ovdessel/NixieSpeaker/NixieRadio.kicad_pcb

## KiCad design NixieRadio.kicad_pcb (2022-07-15)

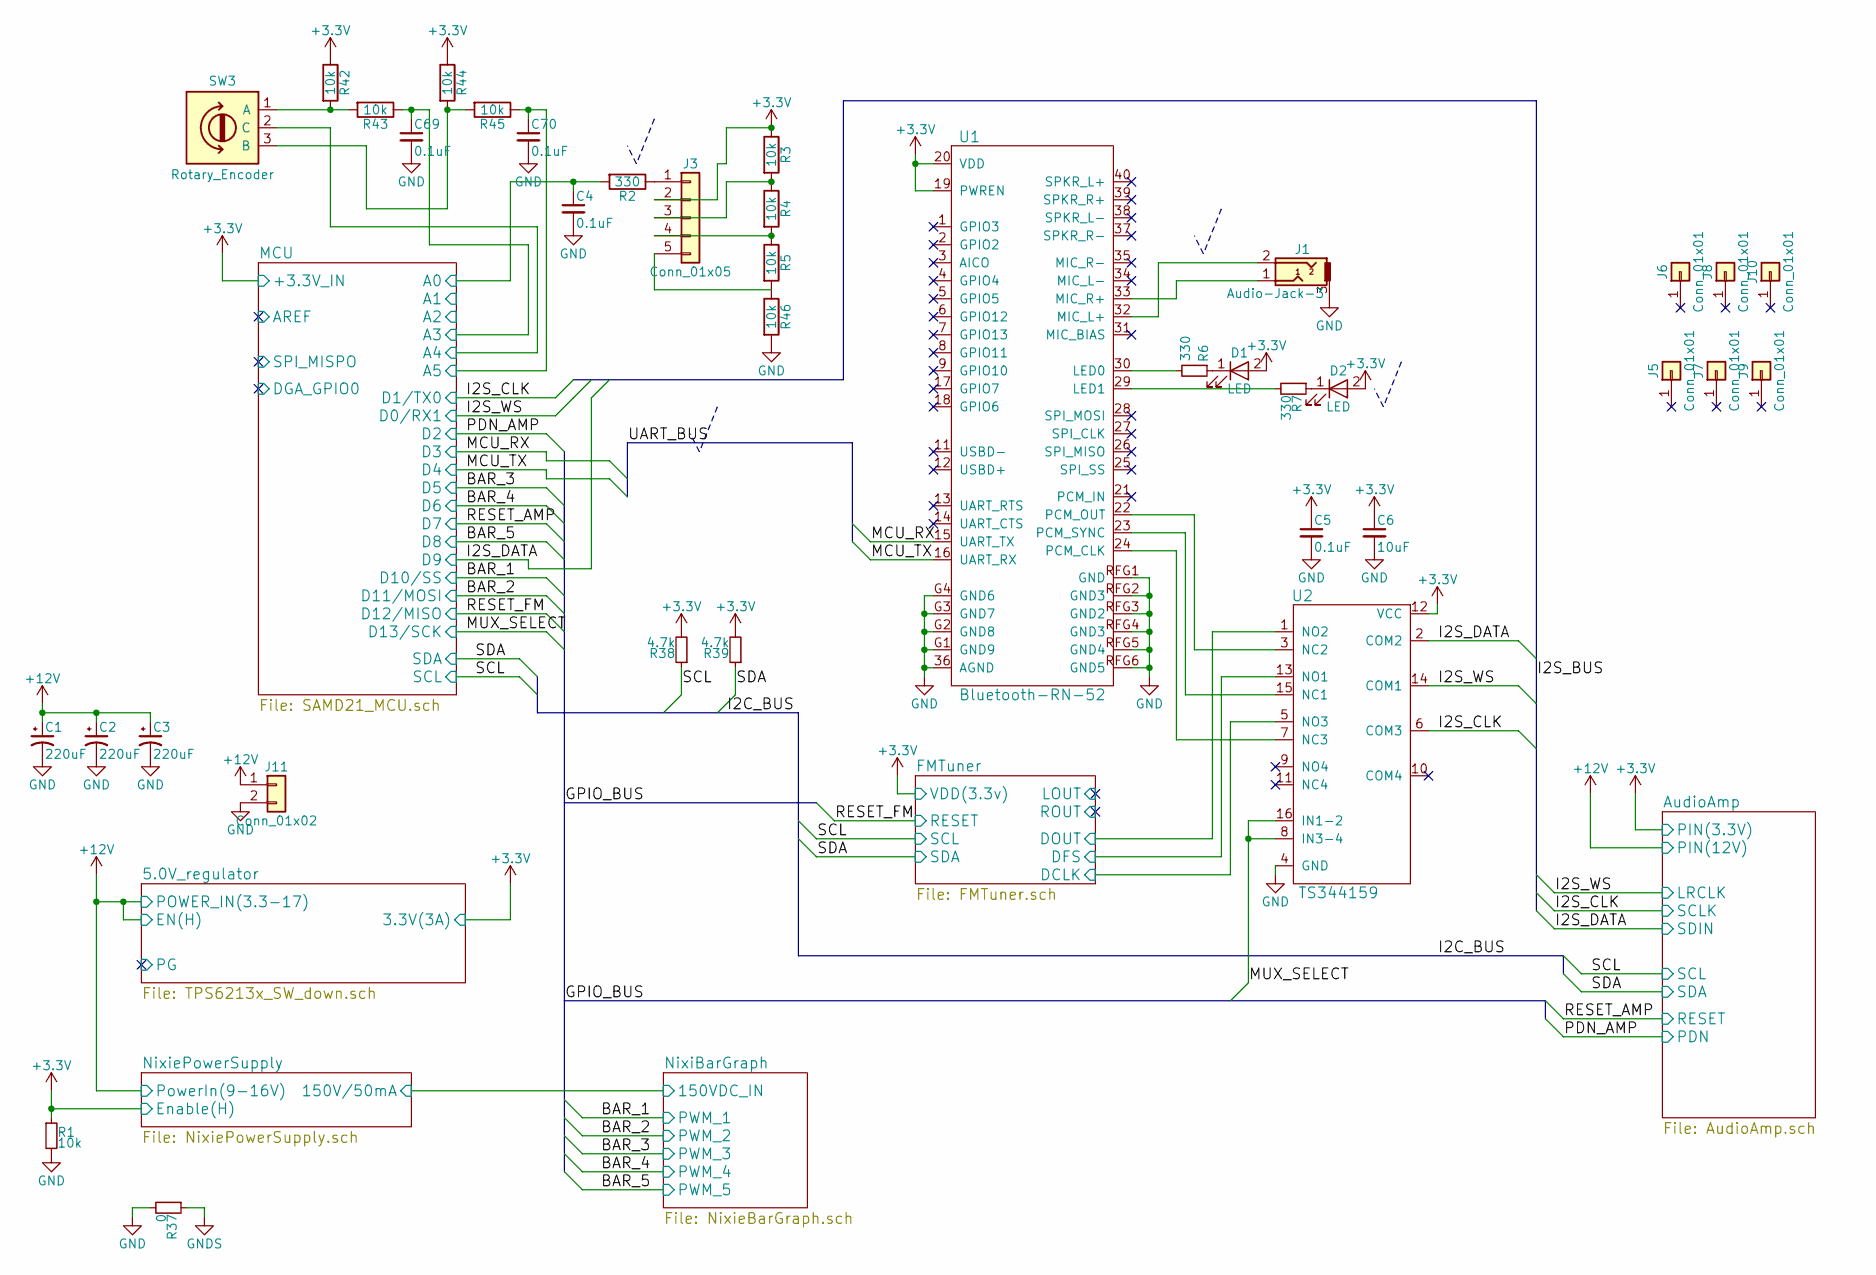
[picture p1: schematic NixieRadio.sch]

Parts:
C1, C2, C3: 220uF; CP_Elec_8x10
C4, C5, C69, C70: 0.1uF; 0603-CAP
C6: 10uF; 0603-CAP
D1, D2: LED; LED_0603
J1: Audio-Jack-3; 1X03
J3: Conn_01x05; 1X05
J5, J6, J7, J8, J9, J10: Conn_01x01; STAND-OFF
J11: Conn_01x02; 1X02_BIG
R1, R3, R4, R5, R42, R43, R44, R45, R46: 10k; 0603-RES
R2, R6, R7: 330; 0603-RES
R37: 0; R_1210_HandSoldering
R38, R39: 4.7k; 0603-RES
SW3: Rotary_Encoder; 1X03
U1: Bluetooth-RN-52; RN-52
U2: TS344159; TSSOP16

Connections:
+3V3: C5.1, C6.1, D1.2 (A), D2.2 (A), J3.2, R1.1, R3.1, R38.2, R39.2, R42.1, R44.1, U1.19 (PWREN), U1.20 (VDD), U2.12 (VCC); also elsewhere on the board
+12V: C1.1, C2.1, C3.1, J11.1; also elsewhere on the board
/FMTuner/DCLK: U2.5 (NO3); also elsewhere on the board
/FMTuner/DFS: U2.13 (NO1); also elsewhere on the board
/FMTuner/DOUT: U2.1 (NO2); also elsewhere on the board
/I2S_CLK: U2.6 (COM3); also elsewhere on the board
/I2S_DATA: U2.2 (COM2); also elsewhere on the board
/I2S_WS: U2.14 (COM1); also elsewhere on the board
/MCU/A0: C4.1, R2.2; also elsewhere on the board
/MCU/A3: C69.1, R43.1; also elsewhere on the board
/MCU/A4: SW3.2 (C); also elsewhere on the board
/MCU/A5: C70.1, R45.1; also elsewhere on the board
/MCU_RX: U1.15 (UART_TX); also elsewhere on the board
/MCU_TX: U1.16 (UART_RX); also elsewhere on the board
/MUX_SELECT: U2.8 (IN3-4), U2.16 (IN1-2); also elsewhere on the board
/SCL: R38.1; also elsewhere on the board
/SDA: R39.1; also elsewhere on the board
GND: C1.2, C2.2, C3.2, C4.2, C5.2, C6.2, C69.2, C70.2, J1.3, J11.2, R1.2, R37.2, R46.2, U1.36 (AGND), U1.G1 (GND9), U1.G2 (GND8), U1.G3 (GND7), U1.G4 (GND6), U1.RFG1 (GND), U1.RFG2 (GND3), U1.RFG3 (GND2), U1.RFG4 (GND3), U1.RFG5 (GND4), U1.RFG6 (GND5), U2.4 (GND); also elsewhere on the board
GNDS: R37.1; also elsewhere on the board
unnamed: D1.1 (K), R6.1
unnamed: D2.1 (K), R7.1
unnamed: J1.1, U1.33 (MIC_R+)
unnamed: J1.2, U1.32 (MIC_L+)
unnamed: J3.1, R2.1
unnamed: J3.3, R3.2, R4.1
unnamed: J3.4, R4.2, R5.1
unnamed: J3.5, R5.2, R46.1
unnamed: R6.2, U1.30 (LED0)
unnamed: R7.2, U1.29 (LED1)
unnamed: R42.2, R43.2, SW3.1 (A)
unnamed: R44.2, R45.2, SW3.3 (B)
unnamed: U1.22 (PCM_OUT), U2.3 (NC2)
unnamed: U1.23 (PCM_SYNC), U2.15 (NC1)
unnamed: U1.24 (PCM_CLK), U2.7 (NC3)

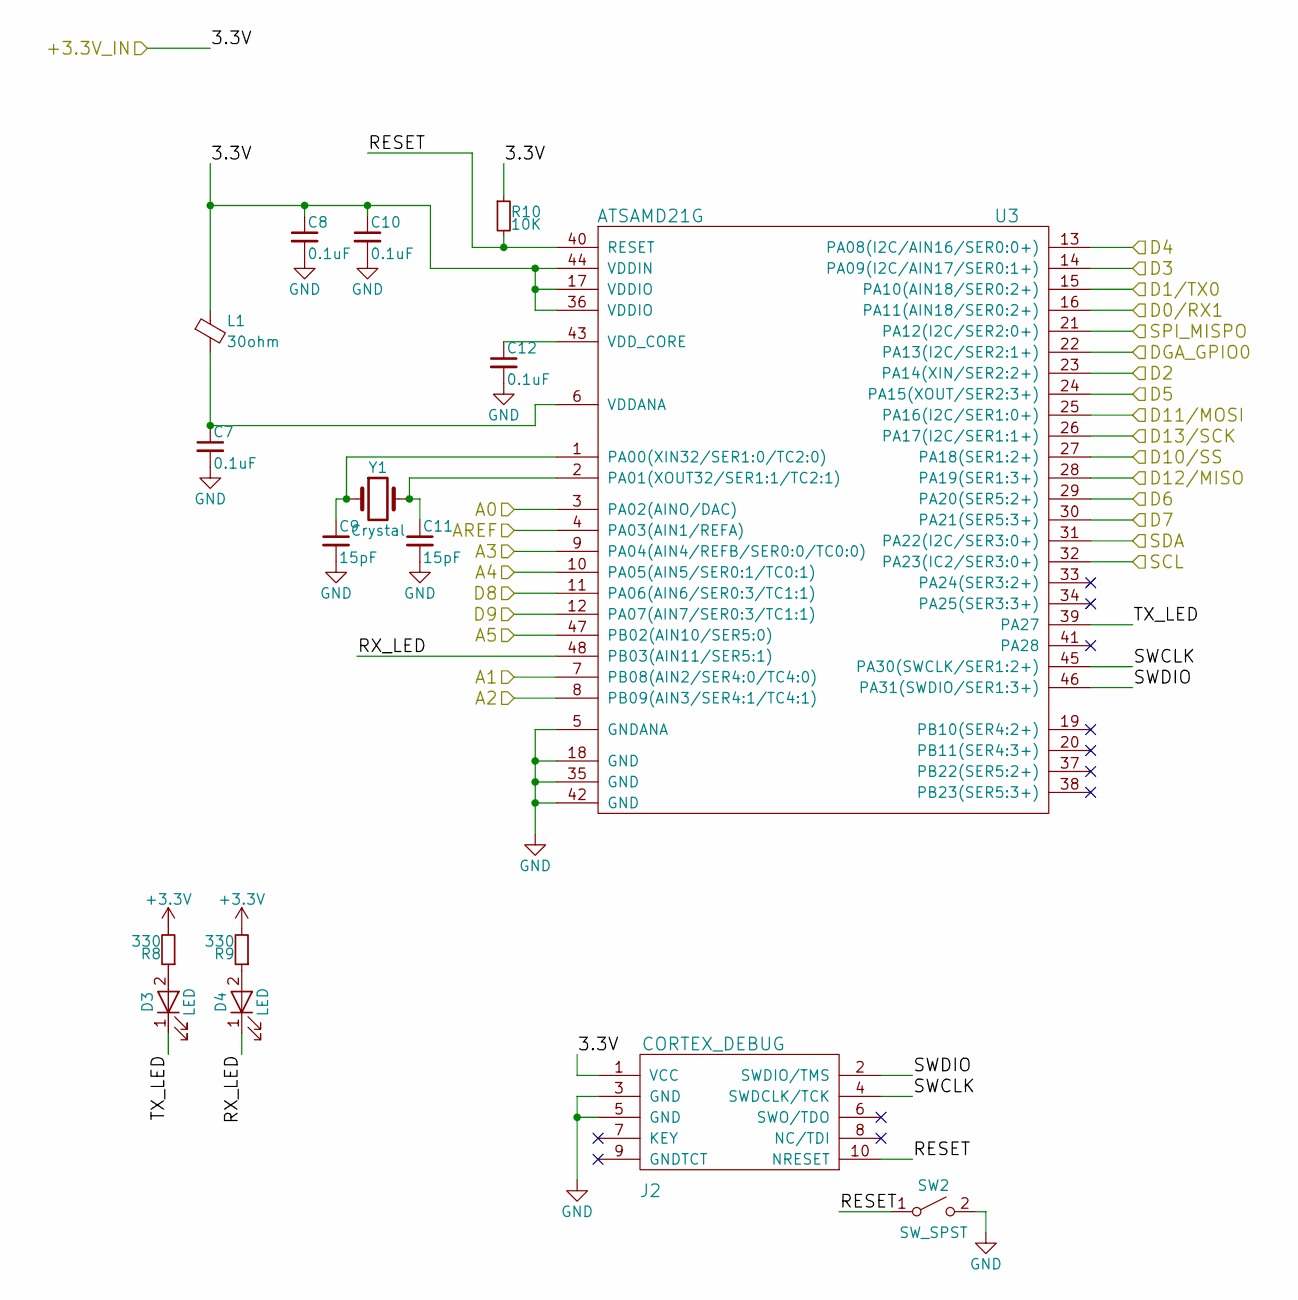
[picture p2: schematic SAMD21_MCU.sch]

Parts:
C7, C8, C10, C12: 0.1uF; 0603-CAP
C9, C11: 15pF; 0603-CAP
D3, D4: LED; LED_0603
J2: CORTEX_DEBUG; 2X5-PTH-1.27MM
L1: 30ohm; R_0603
R8, R9: 330; 0603-RES
R10: 10K; 0603-RES
SW2: SW_SPST; SW_SPST_B3U-1000P
U3: ATSAMD21G; TQFP-48
Y1: Crystal; Crystal_AT310_d3.0mm_l10.0mm_Horizontal

Connections:
+3V3: C8.1, C10.1, J2.1 (VCC), L1.1, R8.2, R9.2, R10.1, U3.17 (VDDIO), U3.36 (VDDIO), U3.44 (VDDIN); also elsewhere on the board
/BAR_1: U3.27 (PA18(SER1:2+)); also elsewhere on the board
/BAR_2: U3.25 (PA16(I2C/SER1:0+)); also elsewhere on the board
/BAR_3: U3.24 (PA15(XOUT/SER2:3+)); also elsewhere on the board
/BAR_4: U3.29 (PA20(SER5:2+)); also elsewhere on the board
/BAR_5: U3.11 (PA06(AIN6/SER0:3/TC1:1)); also elsewhere on the board
/I2S_CLK: U3.15 (PA10(AIN18/SER0:2+)); also elsewhere on the board
/I2S_DATA: U3.12 (PA07(AIN7/SER0:3/TC1:1)); also elsewhere on the board
/I2S_WS: U3.16 (PA11(AIN18/SER0:2+)); also elsewhere on the board
/MCU/A0: U3.3 (PA02(AINO/DAC)); also elsewhere on the board
/MCU/A1: U3.7 (PB08(AIN2/SER4:0/TC4:0))
/MCU/A2: U3.8 (PB09(AIN3/SER4:1/TC4:1))
/MCU/A3: U3.9 (PA04(AIN4/REFB/SER0:0/TC0:0)); also elsewhere on the board
/MCU/A4: U3.10 (PA05(AIN5/SER0:1/TC0:1)); also elsewhere on the board
/MCU/A5: U3.47 (PB02(AIN10/SER5:0)); also elsewhere on the board
/MCU/AREF: U3.4 (PA03(AIN1/REFA))
/MCU/DGA_GPIO0: U3.22 (PA13(I2C/SER2:1+))
/MCU/RESET: J2.10 (NRESET), R10.2, SW2.1 (A), U3.40 (RESET)
/MCU/RX_LED: D4.1 (K), U3.48 (PB03(AIN11/SER5:1))
/MCU/SPI_MISPO: U3.21 (PA12(I2C/SER2:0+))
/MCU/SWCLK: J2.4 (SWDCLK/TCK), U3.45 (PA30(SWCLK/SER1:2+))
/MCU/SWDIO: J2.2 (SWDIO/TMS), U3.46 (PA31(SWDIO/SER1:3+))
/MCU/TX_LED: D3.1 (K), U3.39 (PA27)
/MCU_RX: U3.14 (PA09(I2C/AIN17/SER0:1+)); also elsewhere on the board
/MCU_TX: U3.13 (PA08(I2C/AIN16/SER0:0+)); also elsewhere on the board
/MUX_SELECT: U3.26 (PA17(I2C/SER1:1+)); also elsewhere on the board
/PDN_AMP: U3.23 (PA14(XIN/SER2:2+)); also elsewhere on the board
/RESET_AMP: U3.30 (PA21(SER5:3+)); also elsewhere on the board
/RESET_FM: U3.28 (PA19(SER1:3+)); also elsewhere on the board
/SCL: U3.32 (PA23(IC2/SER3:0+)); also elsewhere on the board
/SDA: U3.31 (PA22(I2C/SER3:0+)); also elsewhere on the board
GND: C7.2, C8.2, C9.2, C10.2, C11.2, C12.2, J2.3 (GND), J2.5 (GND), SW2.2 (B), U3.5 (GNDANA), U3.18 (GND), U3.35 (GND), U3.42 (GND); also elsewhere on the board
unnamed: C7.1, L1.2, U3.6 (VDDANA)
unnamed: C9.1, U3.1 (PA00(XIN32/SER1:0/TC2:0)), Y1.1
unnamed: C11.1, U3.2 (PA01(XOUT32/SER1:1/TC2:1)), Y1.2
unnamed: C12.1, U3.43 (VDD_CORE)
unnamed: D3.2 (A), R8.1
unnamed: D4.2 (A), R9.1

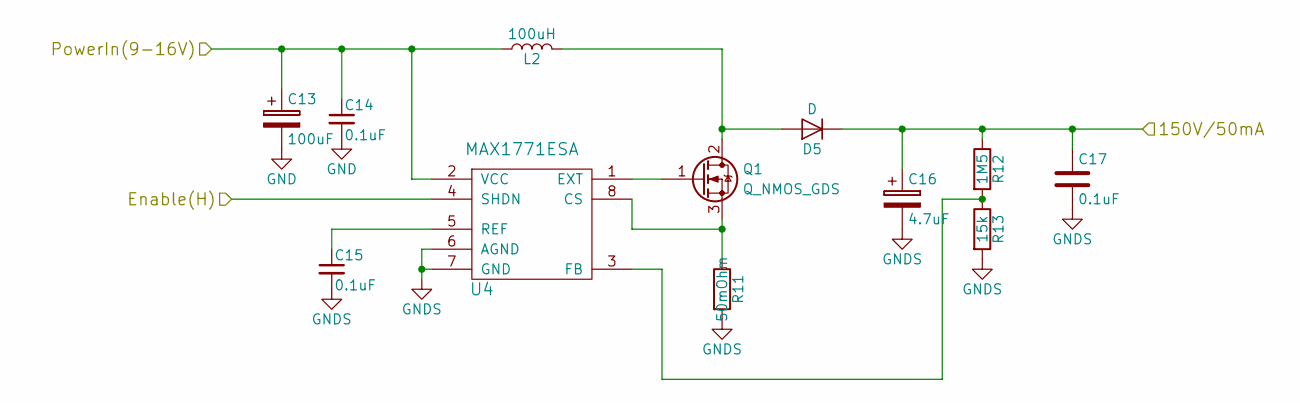
[picture p3: schematic NixiePowerSupply.sch]

Parts:
C13: 100uF; CP_Elec_8x10
C14, C15: 0.1uF; 0603-CAP
C16: 4.7uF; CP_Elec_10x10
C17: 0.1uF; C_2225_HandSoldering
D5: D; D_SMB
L2: 100uH; Inductor_Taiyo-Yuden_NR-80xx_HandSoldering
Q1: Q_NMOS_GDS; TO-220-3_Horizontal_Reversed
R11: 50mOhm; R_1210_HandSoldering
R12: 1M5; R_1210_HandSoldering
R13: 15k; 0603-RES
U4: MAX1771ESA; SO08

Connections:
+3V3: U4.4 (SHDN); also elsewhere on the board
+12V: C13.1, C14.1, L2.1, U4.2 (VCC); also elsewhere on the board
/NixiePowerSupply/150V/50mA: C16.1, C17.1, D5.1 (K), R12.1; also elsewhere on the board
GND: C13.2, C14.2; also elsewhere on the board
GNDS: C15.2, C16.2, C17.2, R11.2, R13.2, U4.6 (AGND), U4.7 (GND); also elsewhere on the board
unnamed: C15.1, U4.5 (REF)
unnamed: D5.2 (A), L2.2, Q1.2 (D)
unnamed: Q1.1 (G), U4.1 (EXT)
unnamed: Q1.3 (S), R11.1, U4.8 (CS)
unnamed: R12.2, R13.1, U4.3 (FB)

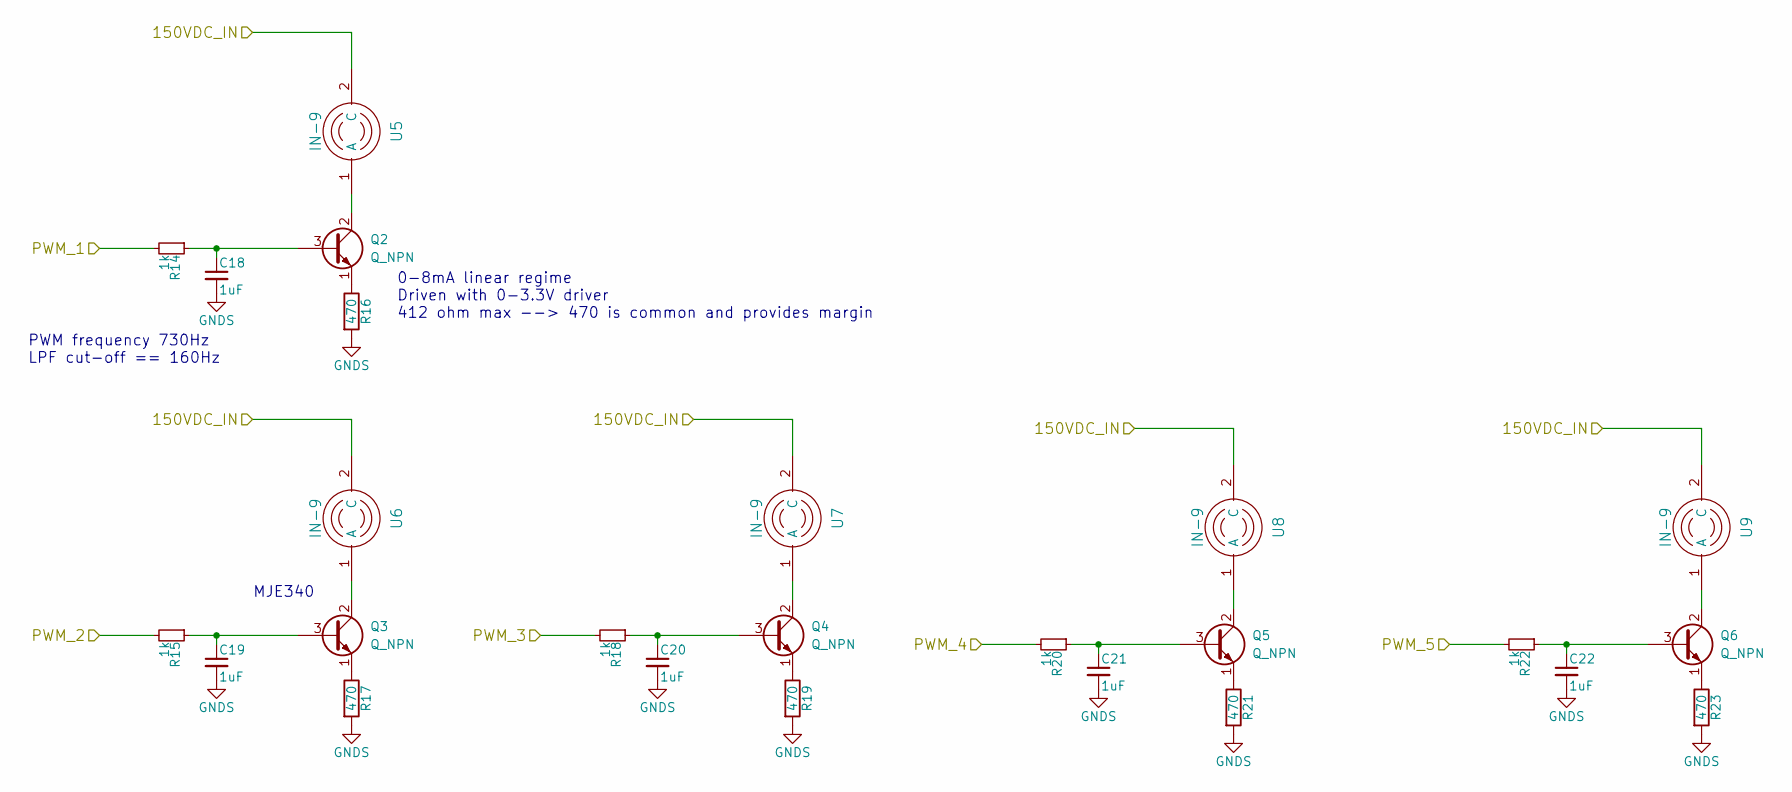
[picture p4: schematic NixieBarGraph.sch]

Parts:
C18, C19, C20, C21, C22: 1uF; 0603-CAP
Q2, Q3, Q4, Q5, Q6: Q_NPN; TO-92
R14, R15, R18, R20, R22: 1k; 0603-RES
R16, R17, R19, R21, R23: 470; 0603-RES
U5, U6, U7, U8, U9: IN-9; 1X02

Connections:
/BAR_1: R14.2; also elsewhere on the board
/BAR_2: R15.2; also elsewhere on the board
/BAR_3: R18.2; also elsewhere on the board
/BAR_4: R20.2; also elsewhere on the board
/BAR_5: R22.2; also elsewhere on the board
/NixiePowerSupply/150V/50mA: U5.2 (C), U6.2 (C), U7.2 (C), U8.2 (C), U9.2 (C); also elsewhere on the board
GNDS: C18.2, C19.2, C20.2, C21.2, C22.2, R16.2, R17.2, R19.2, R21.2, R23.2; also elsewhere on the board
unnamed: C18.1, Q2.3 (B), R14.1
unnamed: C19.1, Q3.3 (B), R15.1
unnamed: C20.1, Q4.3 (B), R18.1
unnamed: C21.1, Q5.3 (B), R20.1
unnamed: C22.1, Q6.3 (B), R22.1
unnamed: Q2.1 (E), R16.1
unnamed: Q2.2 (C), U5.1 (A)
unnamed: Q3.1 (E), R17.1
unnamed: Q3.2 (C), U6.1 (A)
unnamed: Q4.1 (E), R19.1
unnamed: Q4.2 (C), U7.1 (A)
unnamed: Q5.1 (E), R21.1
unnamed: Q5.2 (C), U8.1 (A)
unnamed: Q6.1 (E), R23.1
unnamed: Q6.2 (C), U9.1 (A)

Notes on the sheet:
0-8mA linear regime Driven with 0-3.3V driver 412 ohm max --> 470 is common and provides margin
PWM frequency 730Hz LPF cut-off == 160Hz
MJE340

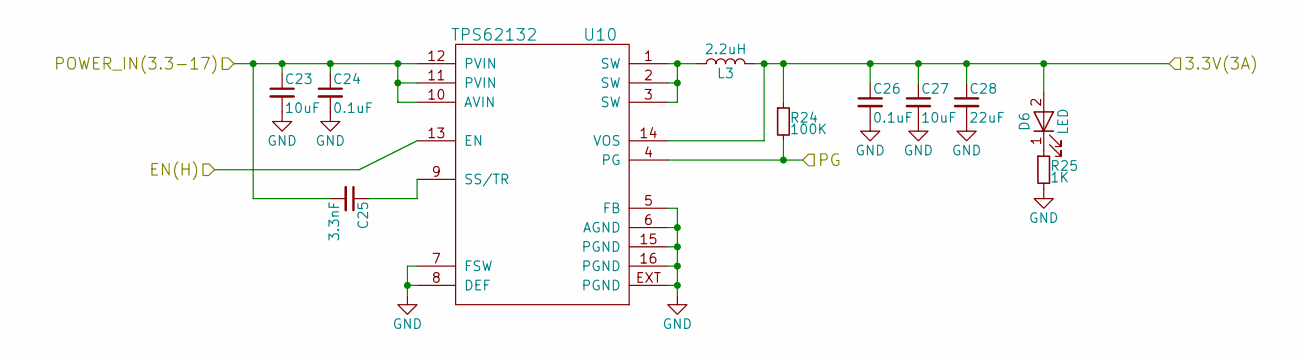
[picture p5: schematic TPS6213x_SW_down.sch]

Parts:
C23, C27: 10uF; 0603-CAP
C24, C26: 0.1uF; 0603-CAP
C25: 3.3nF; 0603-CAP
C28: 22uF; 0603-CAP
D6: LED; LED_0603
L3: 2.2uH; Inductor_1212
R24: 100K; 0603-RES
R25: 1K; 0603-RES
U10: TPS62132; QFN16-3X3MM_1%3a1_V03

Connections:
+3V3: C26.1, C27.1, C28.1, D6.2 (A), L3.2, R24.1, U10.14 (VOS); also elsewhere on the board
+12V: C23.1, C24.1, C25.2, U10.10 (AVIN), U10.11 (PVIN), U10.12 (PVIN), U10.13 (EN); also elsewhere on the board
/5.0V_regulator/PG: R24.2, U10.4 (PG)
GND: C23.2, C24.2, C26.2, C27.2, C28.2, R25.2, U10.5 (FB), U10.6 (AGND), U10.7 (FSW), U10.8 (DEF), U10.15 (PGND), U10.16 (PGND), U10.EXT (PGND); also elsewhere on the board
unnamed: C25.1, U10.9 (SS/TR)
unnamed: D6.1 (K), R25.1
unnamed: L3.1, U10.1 (SW), U10.2 (SW), U10.3 (SW)

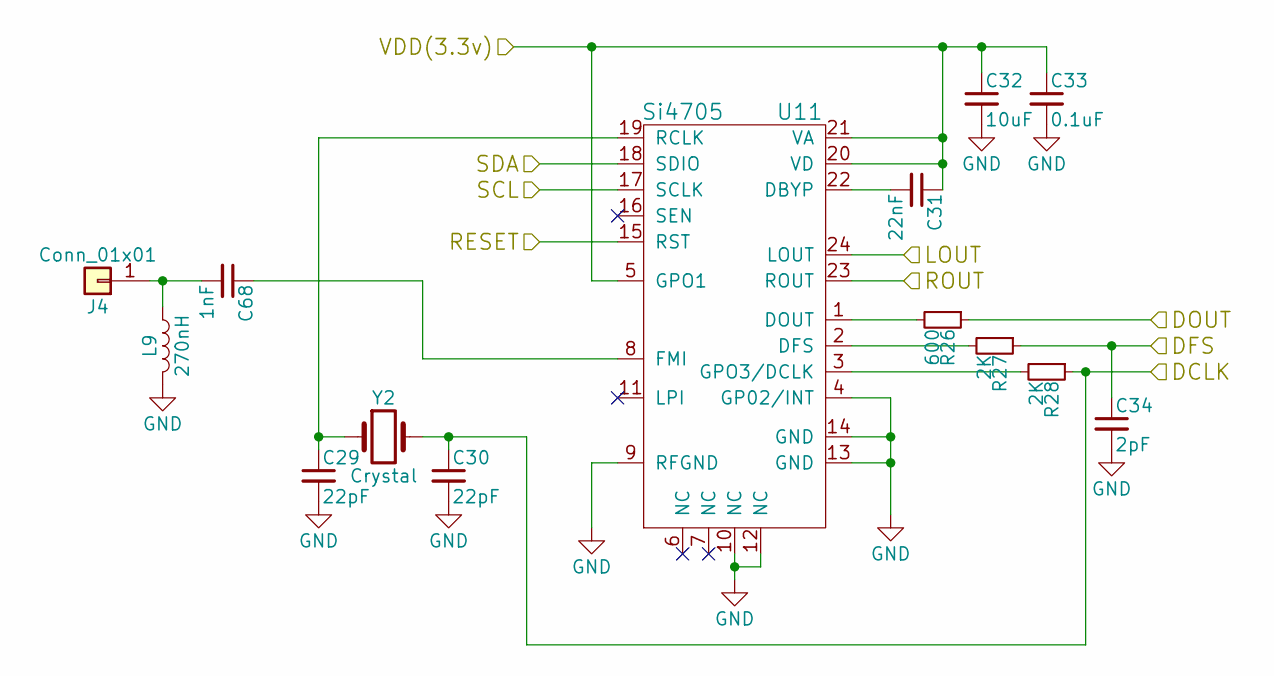
[picture p6: schematic FMTuner.sch]

Parts:
C29, C30: 22pF; 0603-CAP
C31: 22nF; 0603-CAP
C32: 10uF; 0603-CAP
C33: 0.1uF; 0603-CAP
C34: 2pF; 0603-CAP
C68: 1nF; 0603-CAP
J4: Conn_01x01; 1X01
L9: 270nH; Inductor_1212
R26: 600; 0603-RES
R27, R28: 2K; 0603-RES
U11: Si4705; SSOP24
Y2: Crystal; Crystal_AT310_d3.0mm_l10.0mm_Horizontal

Connections:
+3V3: C31.1, C32.1, C33.1, U11.5 (GPO1), U11.20 (VD), U11.21 (VA); also elsewhere on the board
/FMTuner/DCLK: C30.1, R28.1, Y2.2; also elsewhere on the board
/FMTuner/DFS: C34.1, R27.1; also elsewhere on the board
/FMTuner/DOUT: R26.1; also elsewhere on the board
/FMTuner/LOUT: U11.24 (LOUT)
/FMTuner/ROUT: U11.23 (ROUT)
/RESET_FM: U11.15 (RST); also elsewhere on the board
/SCL: U11.17 (SCLK); also elsewhere on the board
/SDA: U11.18 (SDIO); also elsewhere on the board
GND: C29.2, C30.2, C32.2, C33.2, C34.2, L9.2, U11.4 (GP02/INT), U11.9 (RFGND), U11.10 (NC), U11.12 (NC), U11.13 (GND), U11.14 (GND); also elsewhere on the board
unnamed: C29.1, U11.19 (RCLK), Y2.1
unnamed: C31.2, U11.22 (DBYP)
unnamed: C68.1, U11.8 (FMI)
unnamed: C68.2, J4.1, L9.1
unnamed: R26.2, U11.1 (DOUT)
unnamed: R27.2, U11.2 (DFS)
unnamed: R28.2, U11.3 (GPO3/DCLK)

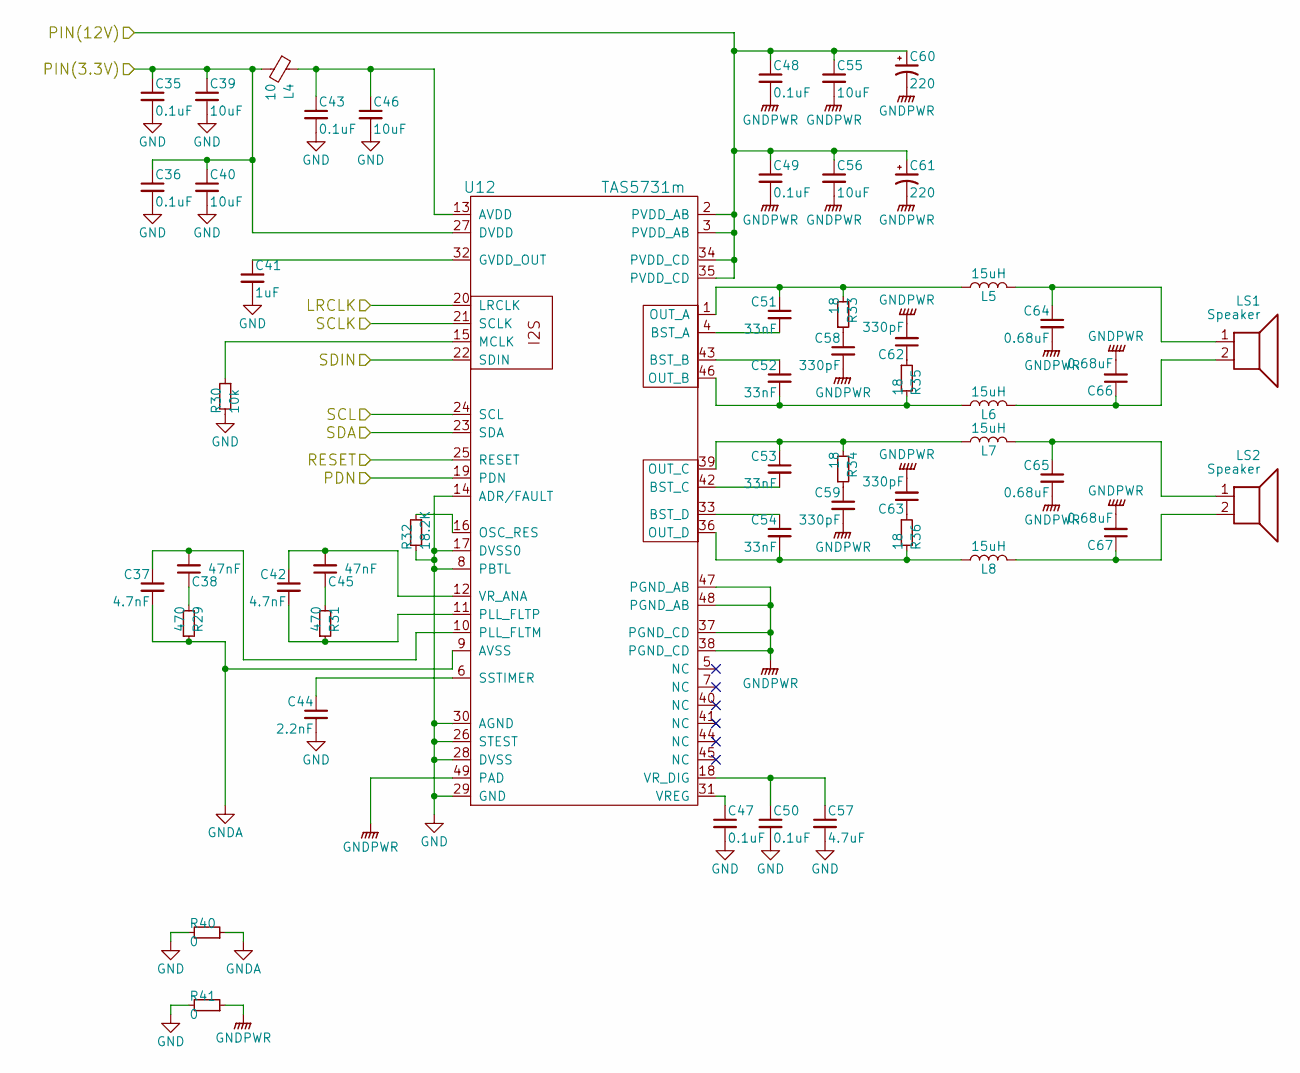
[picture p7: schematic AudioAmp.sch]

Parts:
C35, C36, C43, C47, C48, C49, C50: 0.1uF; 0603-CAP
C37, C42: 4.7nF; 0603-CAP
C38, C45: 47nF; 0603-CAP
C39, C40, C46, C55, C56: 10uF; 0603-CAP
C41: 1uF; 0603-CAP
C44: 2.2nF; 0603-CAP
C51, C52, C53, C54: 33nF; 0603-CAP
C57: 4.7uF; 0603-CAP
C58, C59, C62, C63: 330pF; 0603-CAP
C60, C61: 220; CP_Elec_8x10
C64, C65, C66, C67: 0.68uF; 0603-CAP
L4: 10; R_0603
L5, L6, L7, L8: 15uH; Inductor_Taiyo-Yuden_NR-60xx_HandSoldering
LS1, LS2: Speaker; GTK2400-V2
R29, R31: 470; 0603-RES
R30: 10k; 0603-RES
R32: 18.2K; 0603-RES
R33, R34, R35, R36: 18; 0603-RES
R40, R41: 0; R_1210_HandSoldering
U12: TAS5731m

Connections:
+3V3: C35.1, C36.1, C39.1, C40.1, L4.2, U12.27 (DVDD); also elsewhere on the board
+12V: C48.1, C49.1, C55.1, C56.1, C60.1, C61.1, U12.2 (PVDD_AB), U12.3 (PVDD_AB), U12.34 (PVDD_CD), U12.35 (PVDD_CD); also elsewhere on the board
/I2S_CLK: U12.21 (SCLK); also elsewhere on the board
/I2S_DATA: U12.22 (SDIN); also elsewhere on the board
/I2S_WS: U12.20 (LRCLK); also elsewhere on the board
/PDN_AMP: U12.19 (PDN); also elsewhere on the board
/RESET_AMP: U12.25 (RESET); also elsewhere on the board
/SCL: U12.24 (SCL); also elsewhere on the board
/SDA: U12.23 (SDA); also elsewhere on the board
GND: C35.2, C36.2, C39.2, C40.2, C41.2, C43.2, C44.2, C46.2, C47.2, C50.2, C57.2, R30.2, R32.2, R40.2, R41.2, U12.8 (PBTL), U12.14 (ADR/FAULT), U12.17 (DVSS0), U12.26 (STEST), U12.28 (DVSS), U12.29 (GND), U12.30 (AGND); also elsewhere on the board
GNDA: C37.2, R29.1, R40.1, U12.9 (AVSS)
GNDPWR: C48.2, C49.2, C55.2, C56.2, C58.2, C59.2, C60.2, C61.2, C62.2, C63.2, C64.2, C65.2, C66.2, C67.2, R41.1, U12.37 (PGND_CD), U12.38 (PGND_CD), U12.47 (PGND_AB), U12.48 (PGND_AB), U12.49 (PAD)
unnamed: C37.1, C38.2, U12.10 (PLL_FLTM)
unnamed: C38.1, R29.2
unnamed: C41.1, U12.32 (GVDD_OUT)
unnamed: C42.1, C45.2, U12.12 (VR_ANA)
unnamed: C42.2, R31.1, U12.11 (PLL_FLTP)
unnamed: C43.1, C46.1, L4.1, U12.13 (AVDD)
unnamed: C44.1, U12.6 (SSTIMER)
unnamed: C45.1, R31.2
unnamed: C47.1, U12.31 (VREG)
unnamed: C50.1, C57.1, U12.18 (VR_DIG)
unnamed: C51.1, L5.1, R33.2, U12.1 (OUT_A)
unnamed: C51.2, U12.4 (BST_A)
unnamed: C52.1, U12.43 (BST_B)
unnamed: C52.2, L6.1, R35.2, U12.46 (OUT_B)
unnamed: C53.1, L7.1, R34.2, U12.39 (OUT_C)
unnamed: C53.2, U12.42 (BST_C)
unnamed: C54.1, U12.33 (BST_D)
unnamed: C54.2, L8.1, R36.2, U12.36 (OUT_D)
unnamed: C58.1, R33.1
unnamed: C59.1, R34.1
unnamed: C62.1, R35.1
unnamed: C63.1, R36.1
unnamed: C64.1, L5.2, LS1.1
unnamed: C65.1, L7.2, LS2.1
unnamed: C66.1, L6.2, LS1.2
unnamed: C67.1, L8.2, LS2.2
unnamed: R30.1, U12.15 (MCLK)
unnamed: R32.1, U12.16 (OSC_RES)

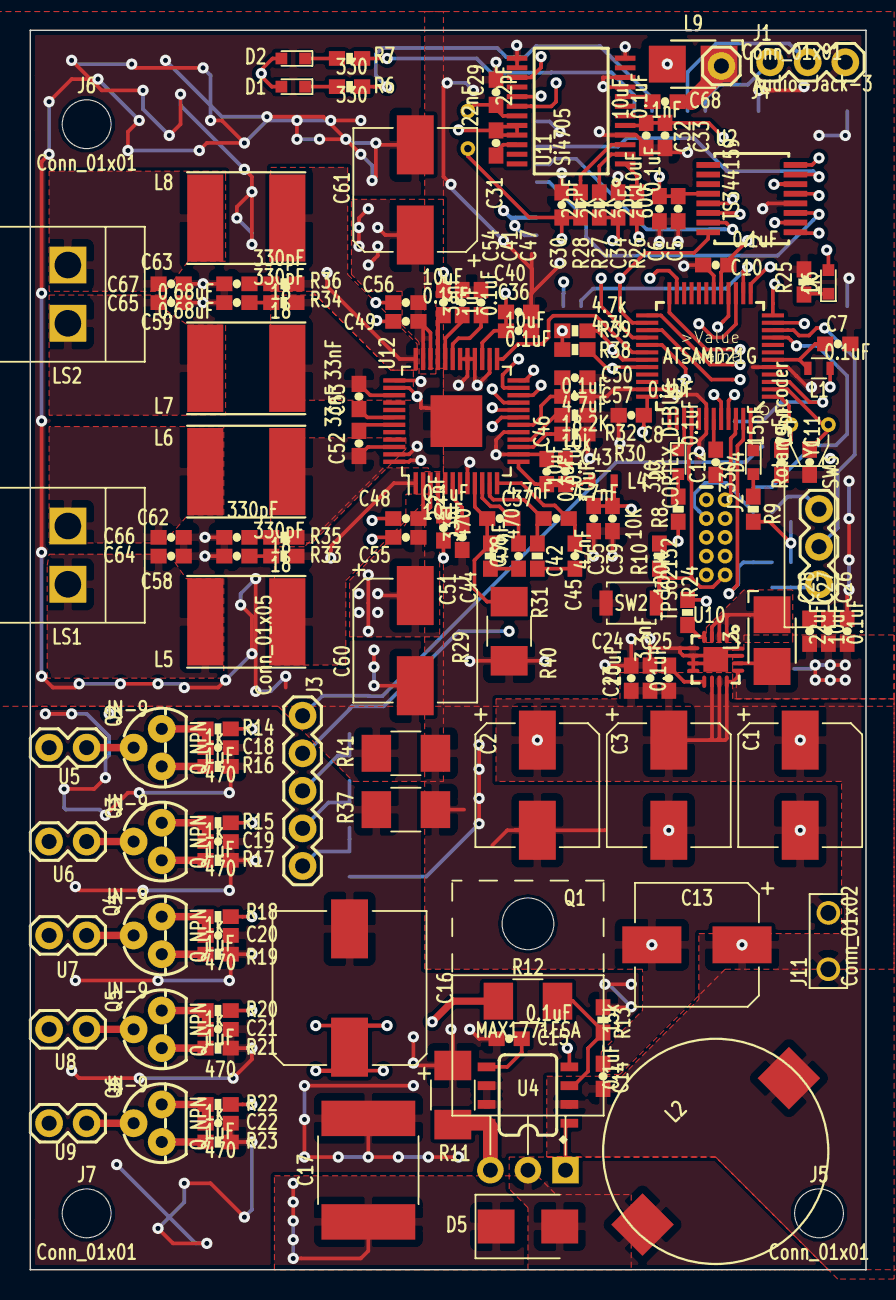
[picture p8: board NixieRadio.kicad_pcb from above]

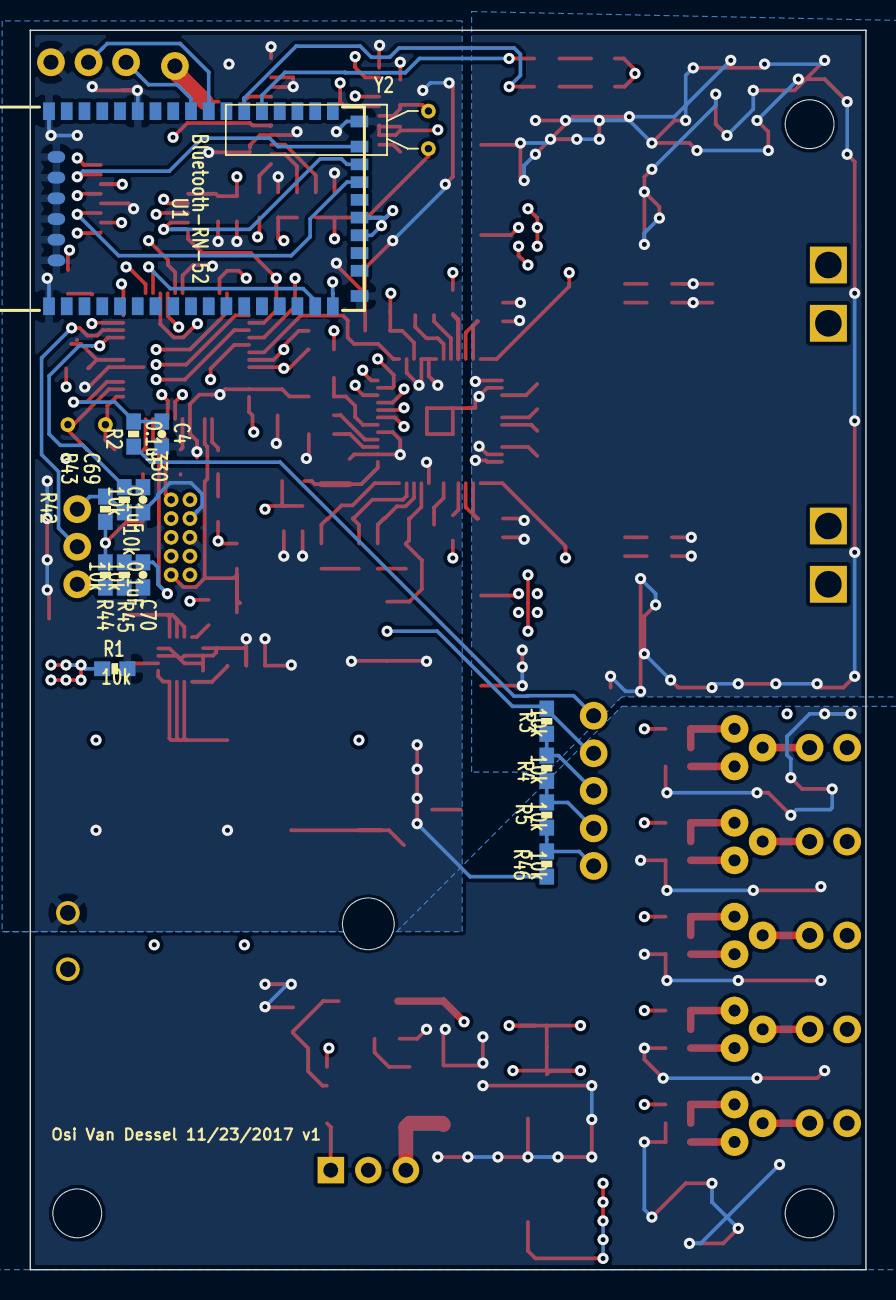
[picture p9: board NixieRadio.kicad_pcb from below]

Board: 4 copper layers, 56.5 x 83.8 mm, 163 parts (15 on the bottom side), 115 nets.
